Ugon/fpga-aes-research/documentation/techniczna/sections/03-system-project.tex

\section{System project}
\label{sec:system-project}
The research of this thesis is focused on evaluation and efficiency comparison of different approaches to implementing AES encryption. This chapter describes proposed AES circuit designs, which are:

\begin{enumerate}[noitemsep]
\item Simple asynchronous architecture
\item Pipelined unrolled architecture with stages of equal critical path
\item Pipelined unrolled architecture with stages containing one ALM
\item Pipelined rolled up architecture with stages containing one ALM
\item Pipelined rolled up architecture using on-chip memory
\end{enumerate}

\subsection{Simple asynchronous architecture}
The most basic approach to implementing AES encryption module is to utilize only combinatorial logic without any optimizations. Such approach was used in Author's BsC thesis \cite{inzynierka} and provides a good baseline for this research.

This approach is asynchronous -- it does not use a clock signal. Encryption is performed at the speed of signal propagation. Pipelining or any other optimizations of throughput or area consumption are not used.

% To test this design for maximum speed of operation it was placed into testing framework described in Chapter \ref{sec:testing-methodology} and clocked. Because this AES circuit is asynchronous, entire enryption algorithm was executen in a single clock cycle of the testing framework. 

% Testing simple asynchronous AES encryption module showed that it is capable of encryptiong only 20M blocks per second and uses 123421????????????? FPGA ALMs. 
% Analysis of compilation reports showed that when increasing frequency, in order to meet timing constraints logic duplication was performed during compilation.

% The conclusion of analysing this approach is that implementing AES encryption in FPGA as an asynchronous circuit is possible, but there is room for optimizations.

\subsection{Pipelined unrolled architecture with stages of equal critical path length}
To achieve high throughput in FPGA designs pipelining is often used \cite[Chapter 1]{kilts2007advanced}. AES encryption algorithm consists of 14 rounds, 13 of which are exactly the same, which means that it can be implemented in two ways:
\begin{description}
\item[Unrolled pipeline] -- there are no loops in the design, parts of the design are not reused. This approach is good for achieving high throughput at the cost of high usage of FPGA resources.
\item[Rolled up pipeline] -- the design contains loops, AES round implementation is reused. This approach is not capable of achieving throughput as high as unrolled pipeline, but its usage of FPGA resources is considerably lower.
\end{description}

This design proposal is based on utilising an unrolled pipeline. Authors of \cite{vlsi} proposed such an architecture divided into pipelined stages of equal critical path length. The fastest of the designs they proposed \cite[Fig. 11]{vlsi} used $r=7$ pipeline stages in each round. This design will be implemented as an entry point to this research of throughput-optimized designs as proposed in \cite{vlsi}.

\subsection{Pipelined unrolled architecture with stages containing one ALM}
\label{sec:unrolled-one-alm}
Next AES circuit proposal is an attempt to improve the throughput of design proposed in \cite{vlsi}. Author suspects that partitioning design into pipelining stages based on critical path length may not be an optimal solution for FPGA platform, because of FPGA's low level properties - utilisation of look-up tables for implementing combinatorial logic in particular.

This design proposal is a modification of the one described in \cite{vlsi}. AES rounds will be partitioned into pipeline stages so that combinatorial logic in each stage can be fit into only one FPGA LUT. The reasoning behind this approach is that higher frequencies could be achieved by avoiding pipeline stages which consist of more than one FPGA LUT, which introduces extra delay caused by additional routing.

FPGA technology details relevant to this approach will be discussed in detail in section \ref{sec:low-level-fpga} and implementation details in \ref{sec:implementation-pipe-unrolled-one-alm}. 

\subsection{Pipelined rolled up architecture with stages containing one ALM}
This circuit design aims to reduce FPGA resource usage of \textit{Pipelined unrolled architecture with stages containing one ALM} at the cost or reducing throughput. It does so by rolling up the pipeline \cite[Chapter 2]{kilts2007advanced} (introducing a loop into the design).

This modification to the circuit proposed in previous section \ref{sec:unrolled-one-alm} reuses the design of a pipelined, throughput-optimized AES round, but instead of repeating it 14 times, it only instantiates it once and creates a loop around it, so that AES state is processed by it 14 times. This modification should result in reducing the number of required FPGA resources roughly 14 times, but also reduce throughput by similar factor. Due to reduced design complexity it might be possible to achieve a little higher maximum frequency.

\subsection{Pipelined rolled up architecture using on-chip memory}
This AES encryption circuit proposal is based on \textit{Pipelined rolled up architecture with stages containing one ALM}. It aims to reduce FPGA resource usage even further by utilising on-chip memory for implementing SubBytes transformation in place of calculating substitution bytes in runtime. 

As SubBytes transformation is the most complex one, this should result in a sizeable circuit area reduction. Because of introducing memory into the circuit, maximum achievable frequency will be bounded by the speed of on-chip RAM (315MHz \cite[Table 27]{cycloneVDatasheet}). This will result in lowering of the throughput.
