Ugon/fpga-aes-research/documentation/techniczna/sections/transformations/AddRoundKey.tex

\subsection{AddRoundKey transformation}

AddRoundKey is a transformation that adds ($xor$) round key to AES state. Round keys are obtained using key expansion routine, which is defined in AES encryption standard \cite{aes-standard}. Expansion algorithm performs byte substitution on some bytes similarly to SubBytes transformation, therefore it can be implemented in two ways as well:

\begin{itemize}[nolistsep]
\item Using a look-up table of precomputed values stored in on-chip memory
\item Using only combinatorial logic.
\end{itemize}

Advantages and disadvantages of both approaches are same as for SubBytes transformation. This section will describe KeyExpansion circuit based on operations already defined in section \ref{sec:sub-bytes}.

To calculate round key for round $N + 1$, keys for rounds $N$ ans $N - 1$ are used. In order to be able to construct pipeline, key expansion for each round needs to be calculated 1 round ahead of time. To perform expansion of key for round $N + 1$ circuit in figure \ref{fig:key-expansion} can be used. Such circuit would be placed in final pipelined design concurrent to round $N$.

Key schedule for first round is 128 highest bits of AES key provided by user. For second round 128 lowest bits of AES key are used. For subsequent rounds key schedules are calculated according to AES key expansion algorithm (\cite{aes-standard}).

\begin{figure}[!h]
\centering
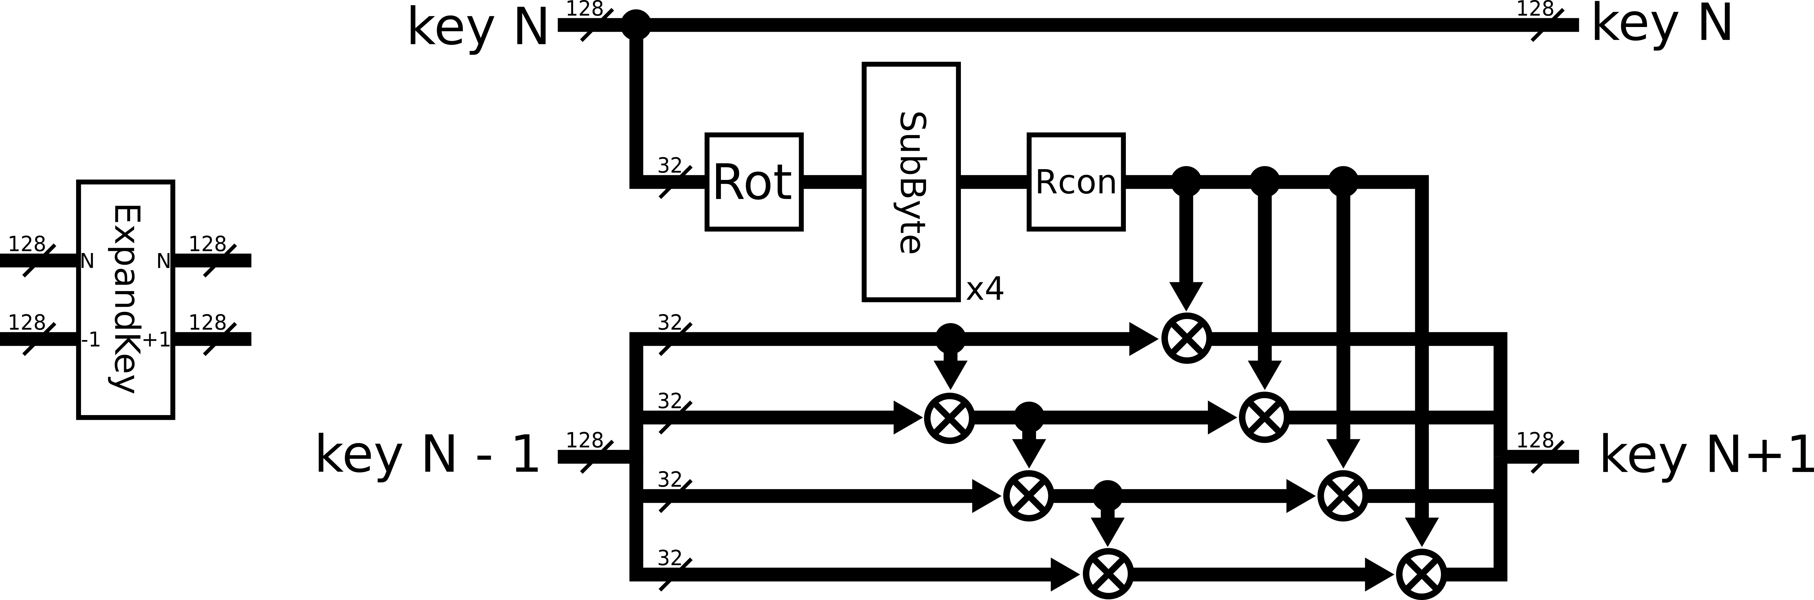
[picture p9: documentation/techniczna/figures/key-expansion.png]

\caption{Key expansion circuit}
\label{fig:key-expansion}
\end{figure}

Operation $Rot$ rotates a word (4 bytes) left by one byte, and $Rcon$ xors highest byte of a word with $2^{(N - 1)/2}$. Those operations are only applied in rounds $N$, where $N \equiv 1 \pmod{2}$.
