Ugon/fpga-aes-research/documentation/techniczna/sections/transformations/ShiftRows.tex

\subsection{ShiftRows transformation}

ShiftRows transformation does not use any combinatorial logic, it only rearranges order of bits in AES state. As a consequence it does not use any FPGA logic resources and only requires adequate routing.

\begin{figure}[!h]
\centering
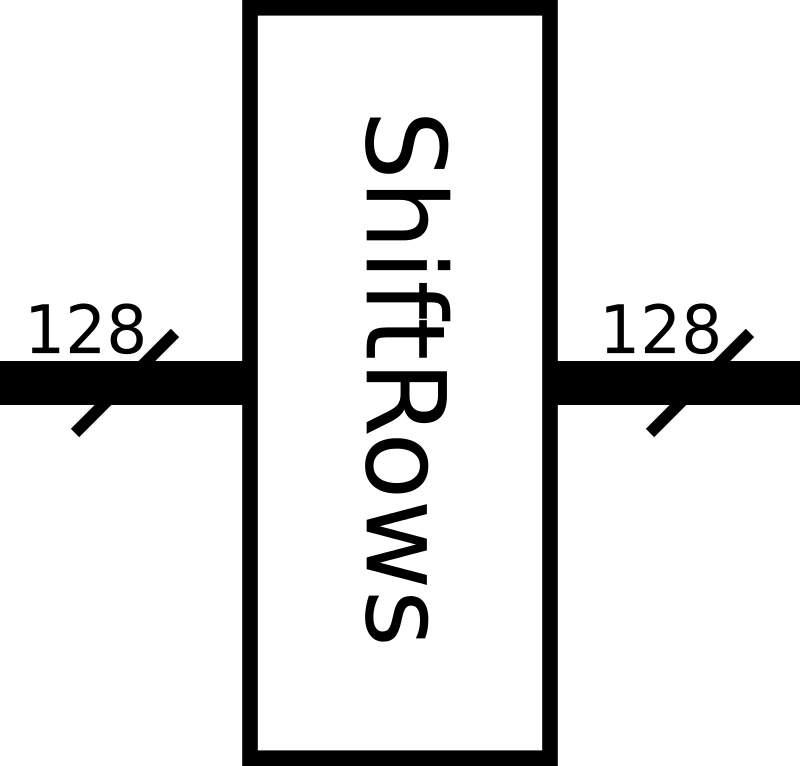
[picture p19: documentation/techniczna/figures/shift-rows.png]

\caption{ShiftRows transformation symbol}
\label{fig:shift-rows}
\end{figure}
