Ugon/fpga-aes-research/documentation/techniczna/figures/high-speed-pipe-full.png

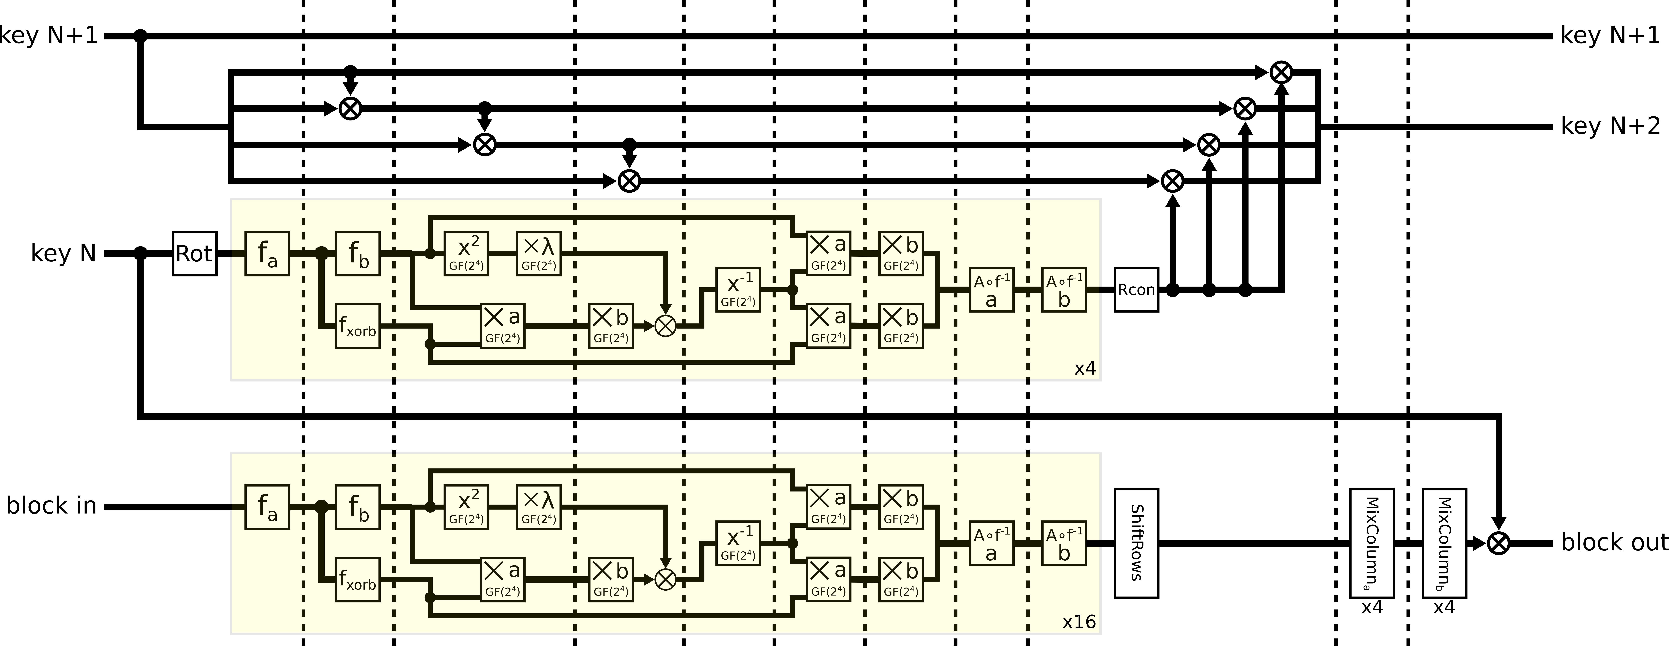
documentation/techniczna/figures/high-speed-pipe-full.png
