Ugon/fpga-aes-research/documentation/techniczna/figures/pipeline-example.png

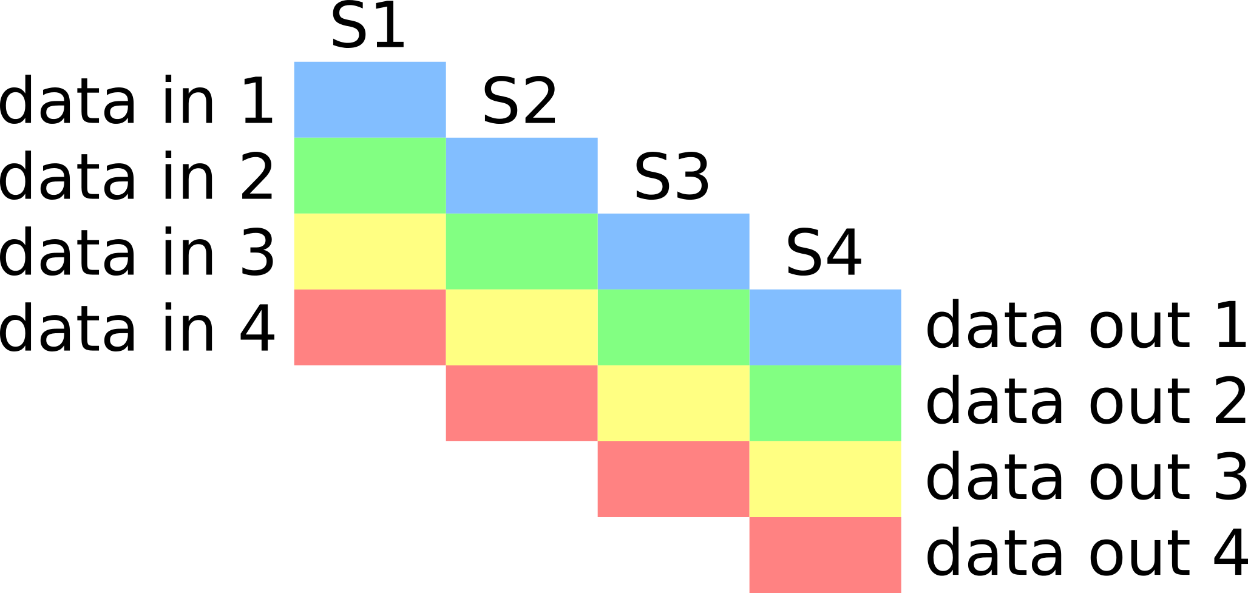
documentation/techniczna/figures/pipeline-example.png
