Ugon/fpga-aes-research/documentation/techniczna/figures/rolled-basic.png

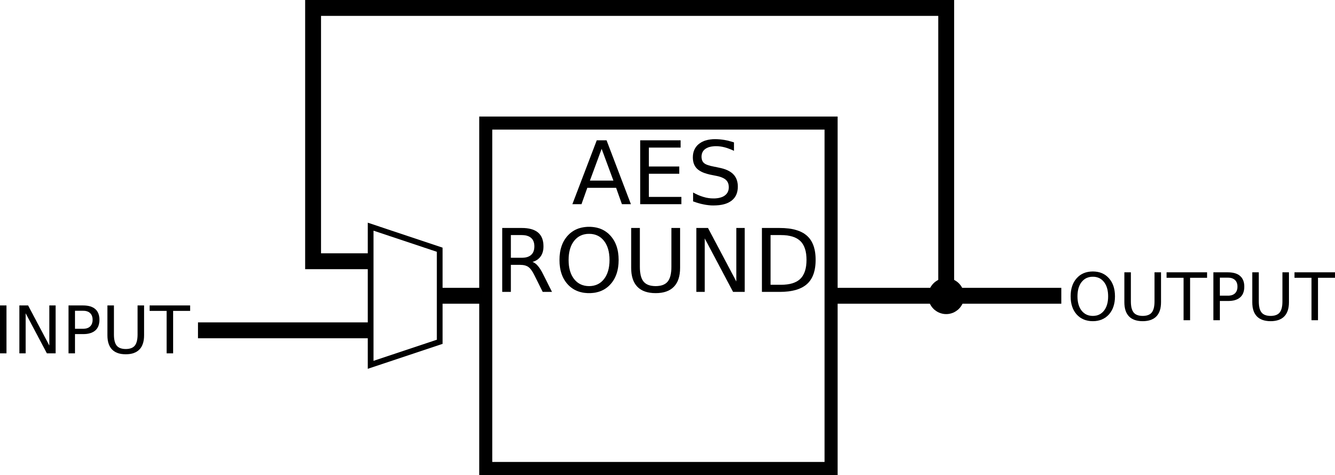
documentation/techniczna/figures/rolled-basic.png
