Ugon/fpga-aes-research/documentation/techniczna/figures/rolled-high-speed-pipe-full.png

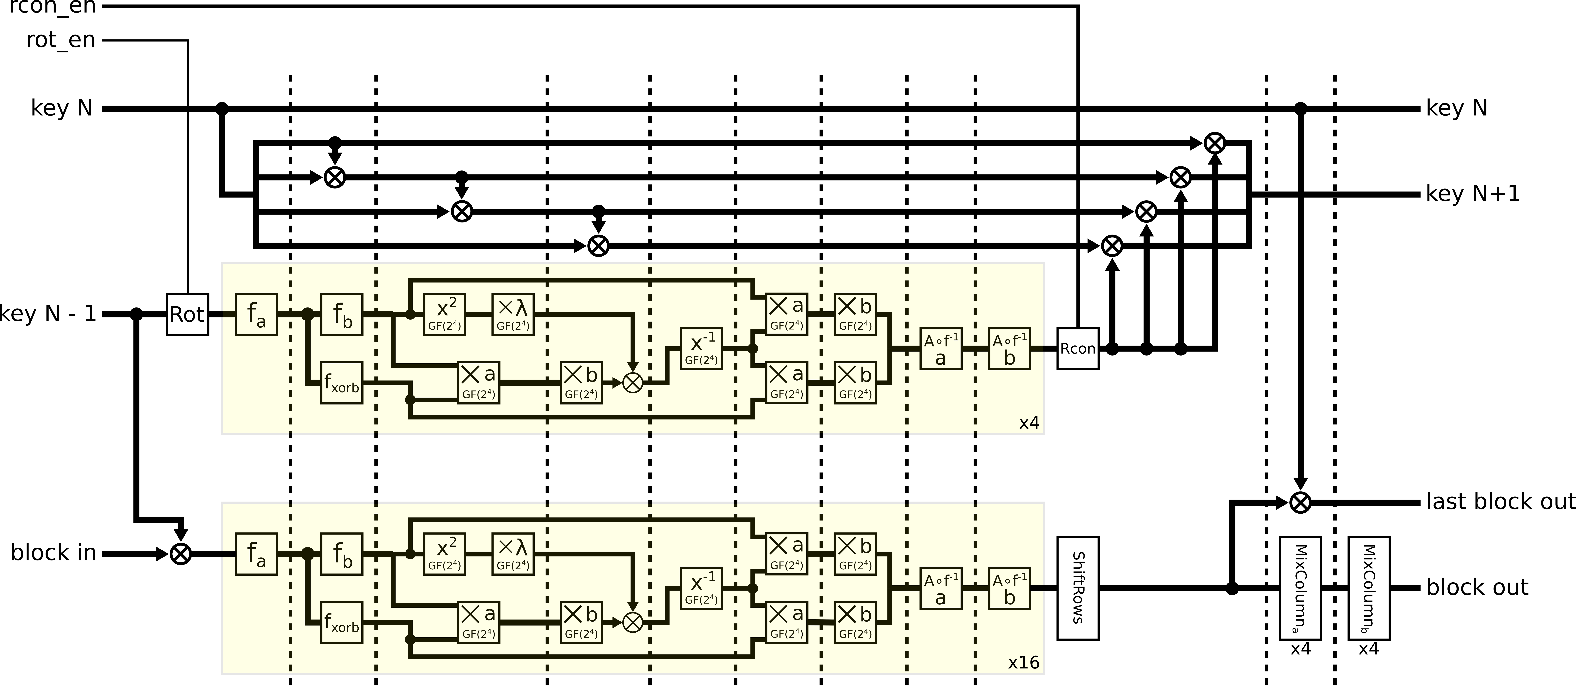
documentation/techniczna/figures/rolled-high-speed-pipe-full.png
