Ugon/fpga-aes-research/documentation/techniczna/figures/simple-alm.png

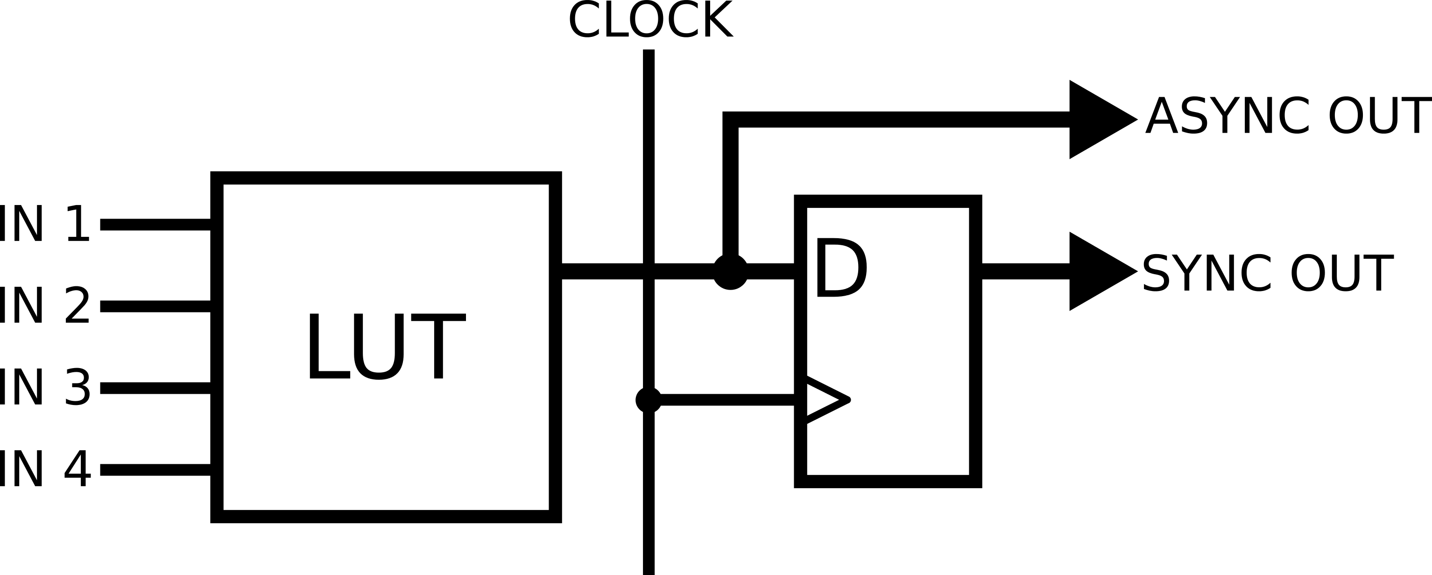
documentation/techniczna/figures/simple-alm.png
