Ugon/fpga-aes-research/documentation/techniczna/figures/unrolled-basic.png

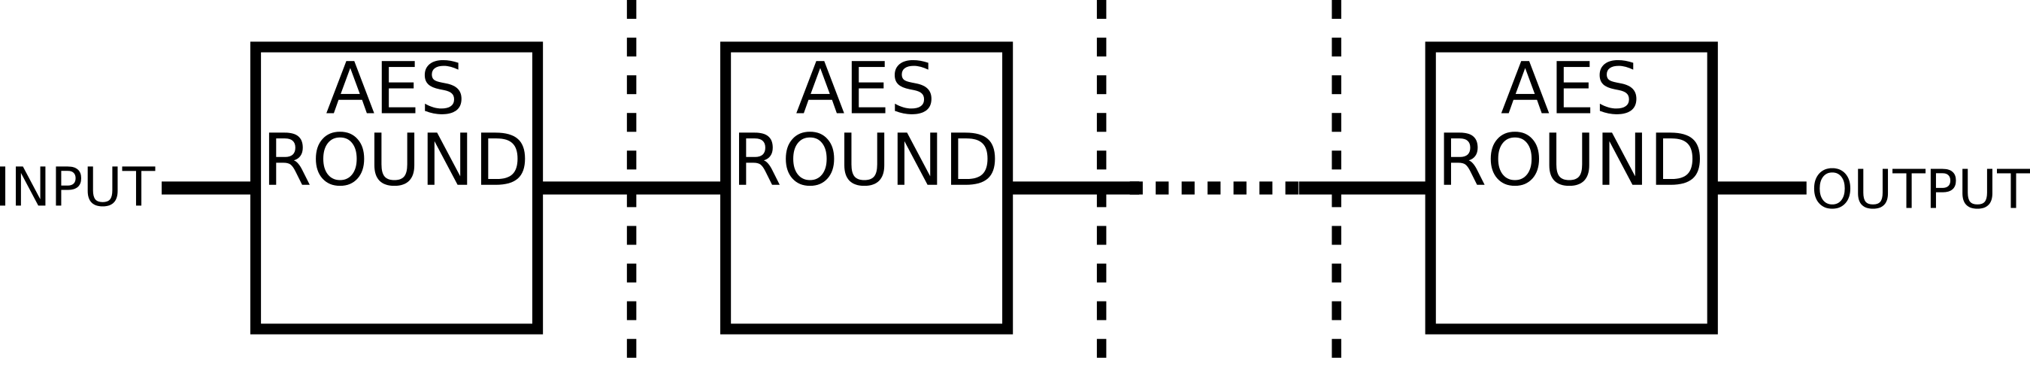
documentation/techniczna/figures/unrolled-basic.png
