Ugon/fpga-aes-research/test/aes/aes_key_expansion_pipe_test.vhd

library ieee;
use ieee.std_logic_1164.all;
use ieee.std_logic_misc.all;
use ieee.numeric_std.all;

use work.aes_sub_bytes.all;
use work.aes_key_expansion_pipe.all;
use work.aes_utils.all;


entity aes_key_expansion_pipe_test is
port (
	clk:     in  std_logic;
	inp_key: in  std_logic_vector(255 downto 0);
	
	round1_key:  out std_logic_vector(127 downto 0);
	round2_key:  out std_logic_vector(127 downto 0);
	round3_key:  out std_logic_vector(127 downto 0);
	round4_key:  out std_logic_vector(127 downto 0);
	round5_key:  out std_logic_vector(127 downto 0);
	round6_key:  out std_logic_vector(127 downto 0);
	round7_key:  out std_logic_vector(127 downto 0);
	round8_key:  out std_logic_vector(127 downto 0);
	round9_key:  out std_logic_vector(127 downto 0);
	round10_key: out std_logic_vector(127 downto 0);
	round11_key: out std_logic_vector(127 downto 0);
	round12_key: out std_logic_vector(127 downto 0);
	round13_key: out std_logic_vector(127 downto 0);
	round14_key: out std_logic_vector(127 downto 0);
	round15_key: out std_logic_vector(127 downto 0);

	round1_key_exp:  in std_logic_vector(127 downto 0);
	round2_key_exp:  in std_logic_vector(127 downto 0);
	round3_key_exp:  in std_logic_vector(127 downto 0);
	round4_key_exp:  in std_logic_vector(127 downto 0);
	round5_key_exp:  in std_logic_vector(127 downto 0);
	round6_key_exp:  in std_logic_vector(127 downto 0);
	round7_key_exp:  in std_logic_vector(127 downto 0);
	round8_key_exp:  in std_logic_vector(127 downto 0);
	round9_key_exp:  in std_logic_vector(127 downto 0);
	round10_key_exp: in std_logic_vector(127 downto 0);
	round11_key_exp: in std_logic_vector(127 downto 0);
	round12_key_exp: in std_logic_vector(127 downto 0);
	round13_key_exp: in std_logic_vector(127 downto 0);
	round14_key_exp: in std_logic_vector(127 downto 0);
	round15_key_exp: in std_logic_vector(127 downto 0);

	round1_eq:  out std_logic;
	round2_eq:  out std_logic;
	round3_eq:  out std_logic;
	round4_eq:  out std_logic;
	round5_eq:  out std_logic;
	round6_eq:  out std_logic;
	round7_eq:  out std_logic;
	round8_eq:  out std_logic;
	round9_eq:  out std_logic;
	round10_eq: out std_logic;
	round11_eq: out std_logic;
	round12_eq: out std_logic;
	round13_eq: out std_logic;
	round14_eq: out std_logic;
	round15_eq: out std_logic
);
end entity aes_key_expansion_pipe_test;

architecture rtl of aes_key_expansion_pipe_test is

	signal r3_key: ake_pipe_result;
	signal r4_key: ake_pipe_result;
	signal r5_key: ake_pipe_result;
	signal r6_key: ake_pipe_result;
	signal r7_key: ake_pipe_result;
	signal r8_key: ake_pipe_result;
	signal r9_key: ake_pipe_result;
	signal r10_key: ake_pipe_result;
	signal r11_key: ake_pipe_result;
	signal r12_key: ake_pipe_result;
	signal r13_key: ake_pipe_result;
	signal r14_key: ake_pipe_result;
	signal r15_key: ake_pipe_result;

begin
	
	r3_key <=  ake_pipe_stage10(ake_pipe_stage9(ake_pipe_stage8(ake_pipe_stage7(ake_pipe_stage6(ake_pipe_stage5(ake_pipe_stage4(ake_pipe_stage3(ake_pipe_stage2(ake_pipe_stage1(inp_key(255 downto 128),  inp_key(127 downto 0),   3),  3),  3),  3),  3),  3),  3),  3),  3),  3);
	r4_key <=  ake_pipe_stage10(ake_pipe_stage9(ake_pipe_stage8(ake_pipe_stage7(ake_pipe_stage6(ake_pipe_stage5(ake_pipe_stage4(ake_pipe_stage3(ake_pipe_stage2(ake_pipe_stage1(r3_key.next_key, r3_key.next_next_key, 4),  4),  4),  4),  4),  4),  4),  4),  4),  4);
/*	r5_key <=  ake_pipe_stage8(ake_pipe_stage7(ake_pipe_stage6(ake_pipe_stage5(ake_pipe_stage4(ake_pipe_stage3(ake_pipe_stage2(ake_pipe_stage1(r3_key_latched_current,  r4_key_latched_next,   5),  5),  5),  5),  5),  5),  5),  5);
	r6_key <=  ake_pipe_stage8(ake_pipe_stage7(ake_pipe_stage6(ake_pipe_stage5(ake_pipe_stage4(ake_pipe_stage3(ake_pipe_stage2(ake_pipe_stage1(r4_key_latched_current,  r5_key_latched_next,   6),  6),  6),  6),  6),  6),  6),  6);
	r7_key <=  ake_pipe_stage8(ake_pipe_stage7(ake_pipe_stage6(ake_pipe_stage5(ake_pipe_stage4(ake_pipe_stage3(ake_pipe_stage2(ake_pipe_stage1(r5_key_latched_current,  r6_key_latched_next,   7),  7),  7),  7),  7),  7),  7),  7);
	r8_key <=  ake_pipe_stage8(ake_pipe_stage7(ake_pipe_stage6(ake_pipe_stage5(ake_pipe_stage4(ake_pipe_stage3(ake_pipe_stage2(ake_pipe_stage1(r6_key_latched_current,  r7_key_latched_next,   8),  8),  8),  8),  8),  8),  8),  8);
	r9_key <=  ake_pipe_stage8(ake_pipe_stage7(ake_pipe_stage6(ake_pipe_stage5(ake_pipe_stage4(ake_pipe_stage3(ake_pipe_stage2(ake_pipe_stage1(r7_key_latched_current,  r8_key_latched_next,   9),  9),  9),  9),  9),  9),  9),  9);
	r10_key <= ake_pipe_stage8(ake_pipe_stage7(ake_pipe_stage6(ake_pipe_stage5(ake_pipe_stage4(ake_pipe_stage3(ake_pipe_stage2(ake_pipe_stage1(r8_key_latched_current,  r9_key_latched_next,  10), 10), 10), 10), 10), 10), 10), 10);
	r11_key <= ake_pipe_stage8(ake_pipe_stage7(ake_pipe_stage6(ake_pipe_stage5(ake_pipe_stage4(ake_pipe_stage3(ake_pipe_stage2(ake_pipe_stage1(r9_key_latched_current,  r10_key_latched_next, 11), 11), 11), 11), 11), 11), 11), 11);
	r12_key <= ake_pipe_stage8(ake_pipe_stage7(ake_pipe_stage6(ake_pipe_stage5(ake_pipe_stage4(ake_pipe_stage3(ake_pipe_stage2(ake_pipe_stage1(r10_key_latched_current, r11_key_latched_next, 12), 12), 12), 12), 12), 12), 12), 12);
	r13_key <= ake_pipe_stage8(ake_pipe_stage7(ake_pipe_stage6(ake_pipe_stage5(ake_pipe_stage4(ake_pipe_stage3(ake_pipe_stage2(ake_pipe_stage1(r11_key_latched_current, r12_key_latched_next, 13), 13), 13), 13), 13), 13), 13), 13);
	r14_key <= ake_pipe_stage8(ake_pipe_stage7(ake_pipe_stage6(ake_pipe_stage5(ake_pipe_stage4(ake_pipe_stage3(ake_pipe_stage2(ake_pipe_stage1(r12_key_latched_current, r13_key_latched_next, 14), 14), 14), 14), 14), 14), 14), 14);
	r15_key <= ake_pipe_stage8(ake_pipe_stage7(ake_pipe_stage6(ake_pipe_stage5(ake_pipe_stage4(ake_pipe_stage3(ake_pipe_stage2(ake_pipe_stage1(r13_key_latched_current, r14_key_latched_next, 15), 15), 15), 15), 15), 15), 15), 15);
*/
	round3_key <= r3_key.next_next_key;
	round4_key <= r4_key.next_next_key;

	--round1_eq <= '1' when r1_key_latched_current = round1_key_exp else '0';

/*	process(clk) begin
		if (rising_edge(clk)) then
			r1_key_latched_current <= inp_key(255 downto 128);
			r2_key_latched_current <= r2_key_latched_next;
			r3_key_latched_current <= r3_key_latched_next;
			r4_key_latched_current <= r4_key_latched_next;
			r5_key_latched_current <= r5_key_latched_next;
			r6_key_latched_current <= r6_key_latched_next;
			r7_key_latched_current <= r7_key_latched_next;
			r8_key_latched_current <= r8_key_latched_next;
			r9_key_latched_current <= r9_key_latched_next;
			r10_key_latched_current <= r10_key_latched_next;
			r11_key_latched_current <= r11_key_latched_next;
			r12_key_latched_current <= r12_key_latched_next;
			r13_key_latched_current <= r13_key_latched_next;
			r14_key_latched_current <= r14_key_latched_next;
			r15_key_latched_current <= r15_key_latched_next;

			r2_key_latched_next <= inp_key(127 downto 0);
			r3_key_latched_next <= r3_key;
			r4_key_latched_next <= r4_key;
			r5_key_latched_next <= r5_key;
			r6_key_latched_next <= r6_key;
			r7_key_latched_next <= r7_key;
			r8_key_latched_next <= r8_key;
			r9_key_latched_next <= r9_key;
			r10_key_latched_next <= r10_key;
			r11_key_latched_next <= r11_key;
			r12_key_latched_next <= r12_key;
			r13_key_latched_next <= r13_key;
			r14_key_latched_next <= r14_key;
			r15_key_latched_next <= r15_key;
		end if;
	end process;
*/
end architecture rtl;
