Ugon/fpga-aes-research/(commit log)

2017-09-10 high speed testing framework
2017-12-31 SubBytes prototype and doc
